hackwerken/SensorGrid-PCB/pdf/sensorGridPcb-3d-2.jpg

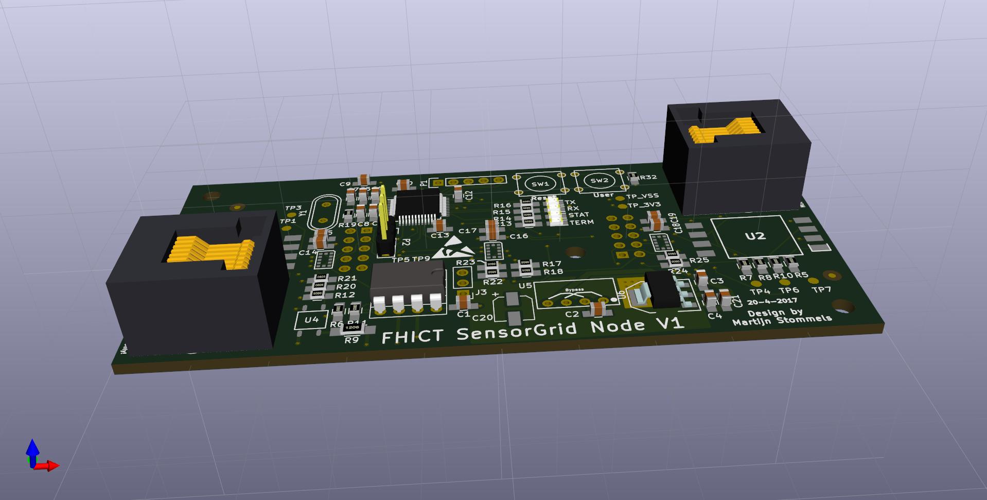
pdf/sensorGridPcb-3d-2.jpg
