hackwerken/SensorGrid-PCB/pdf/sensorGridPcb-3d-4.jpg

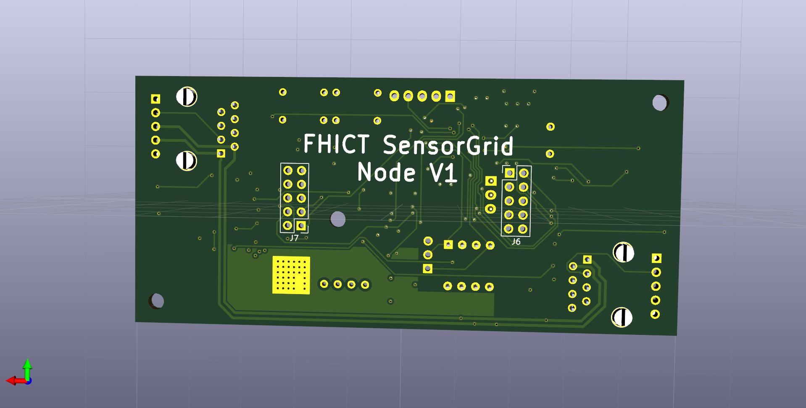
pdf/sensorGridPcb-3d-4.jpg
