hackwerken/SensorGrid-PCB/pdf/sensorGridPcb-3d-1.jpg

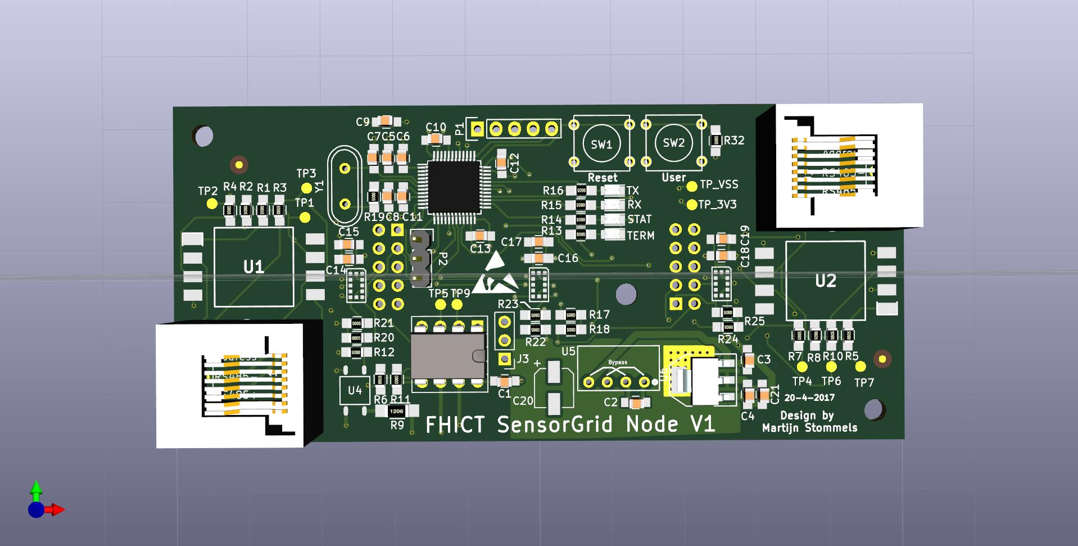
pdf/sensorGridPcb-3d-1.jpg
