hackwerken/SensorGrid-PCB/pdf/sensorGridPcb-3d-3.jpg

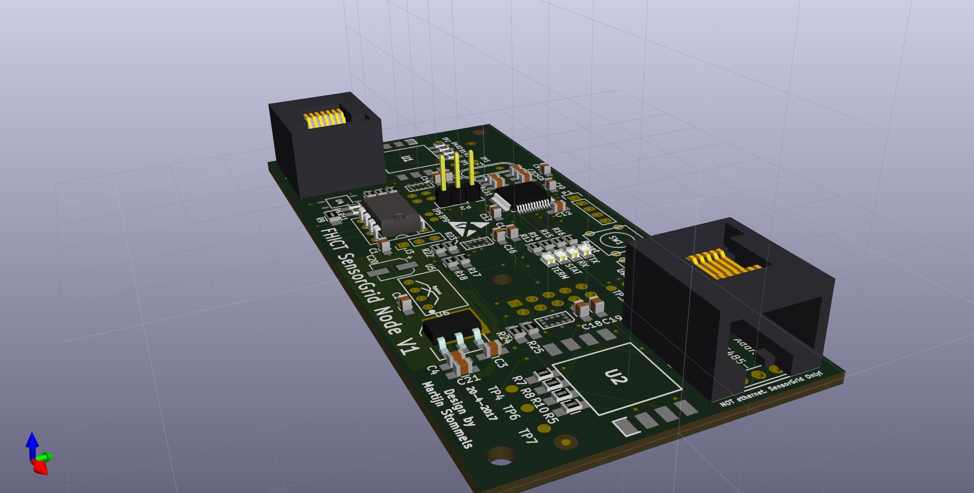
pdf/sensorGridPcb-3d-3.jpg
