hackwerken/SensorGrid-PCB/pdf/sensorGridSchematic.pdf

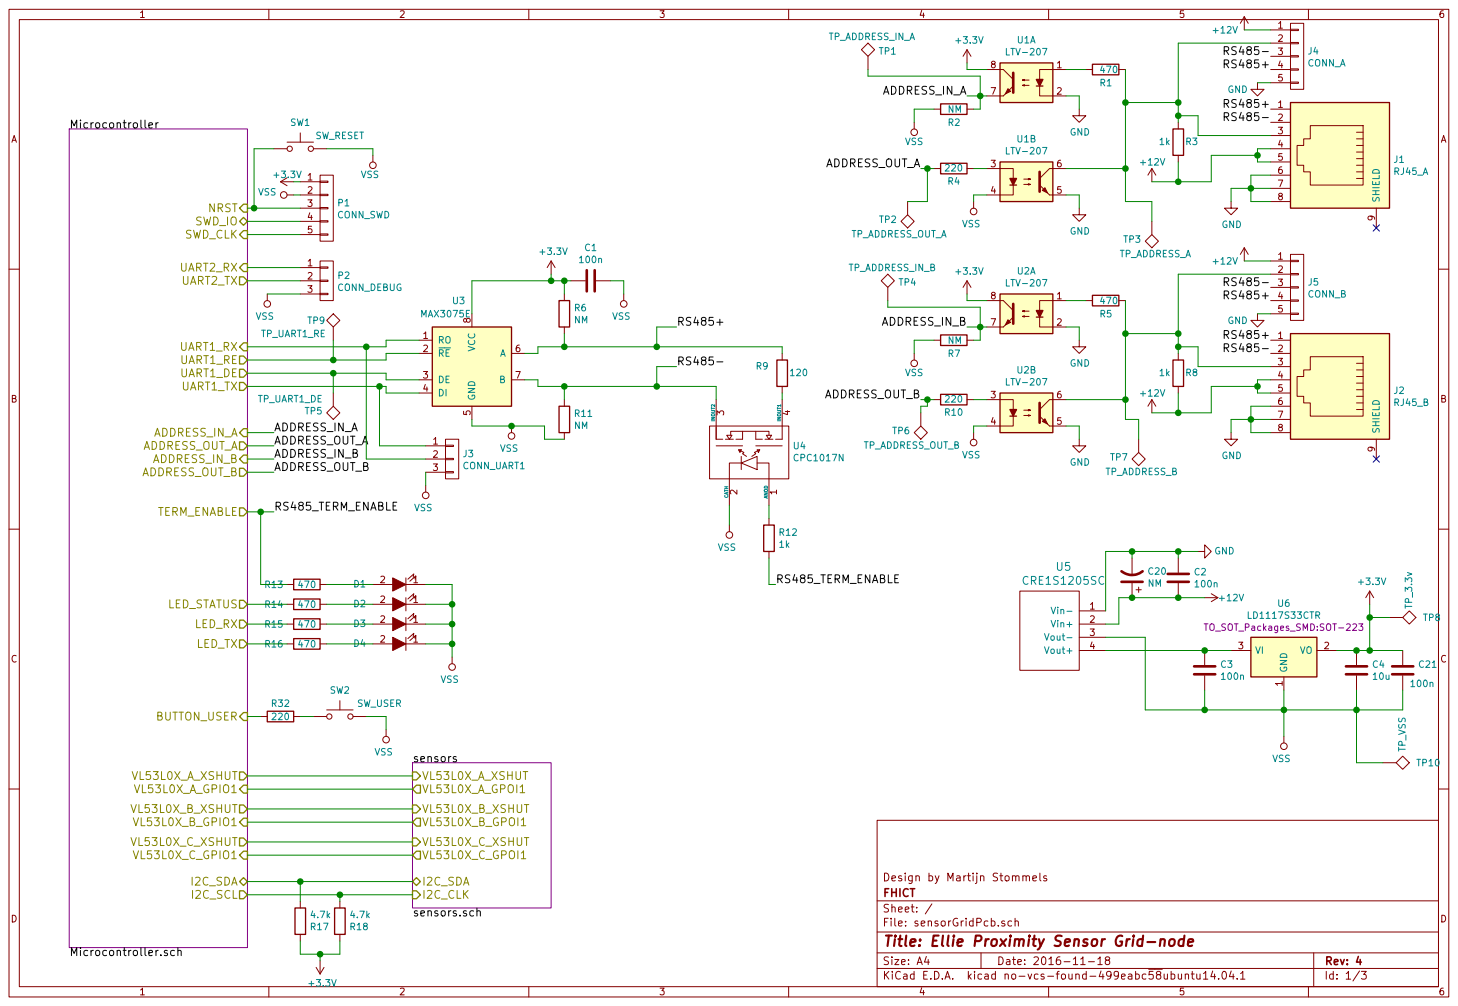
[picture p5: page 1]

File: sensorGridPcb.sch Sheet: / FHICT Design by Martijn Stommels

Id: 1/3 Title: Ellie Proximity Sensor Grid-node

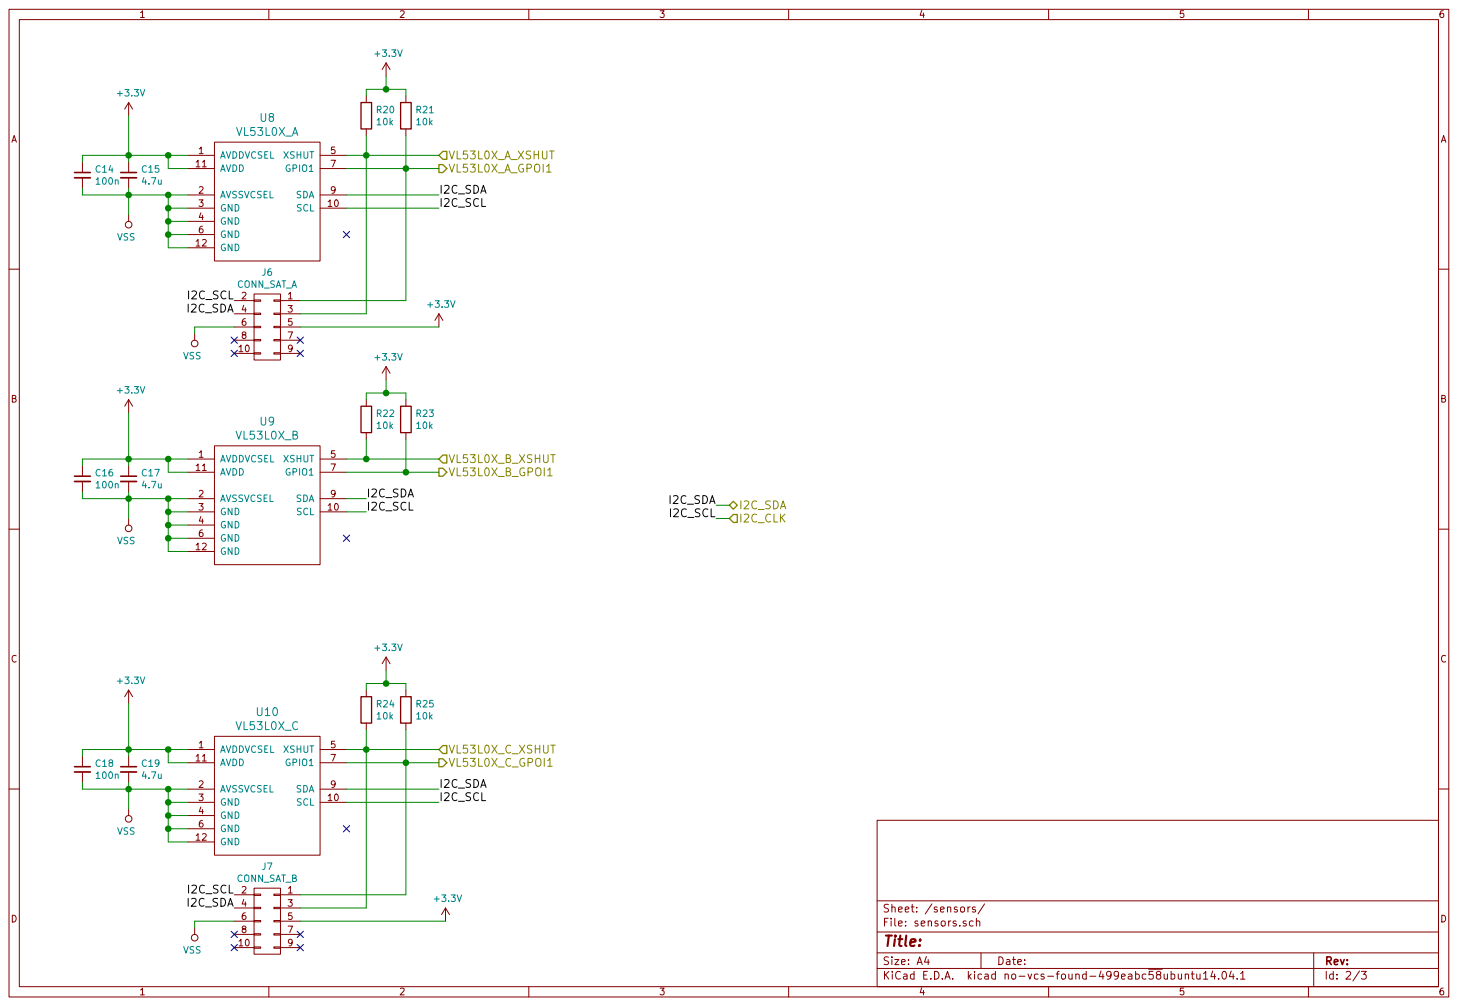
[picture p6: page 2]

Id: 2/3 Title: File: sensors.sch Sheet: /sensors/

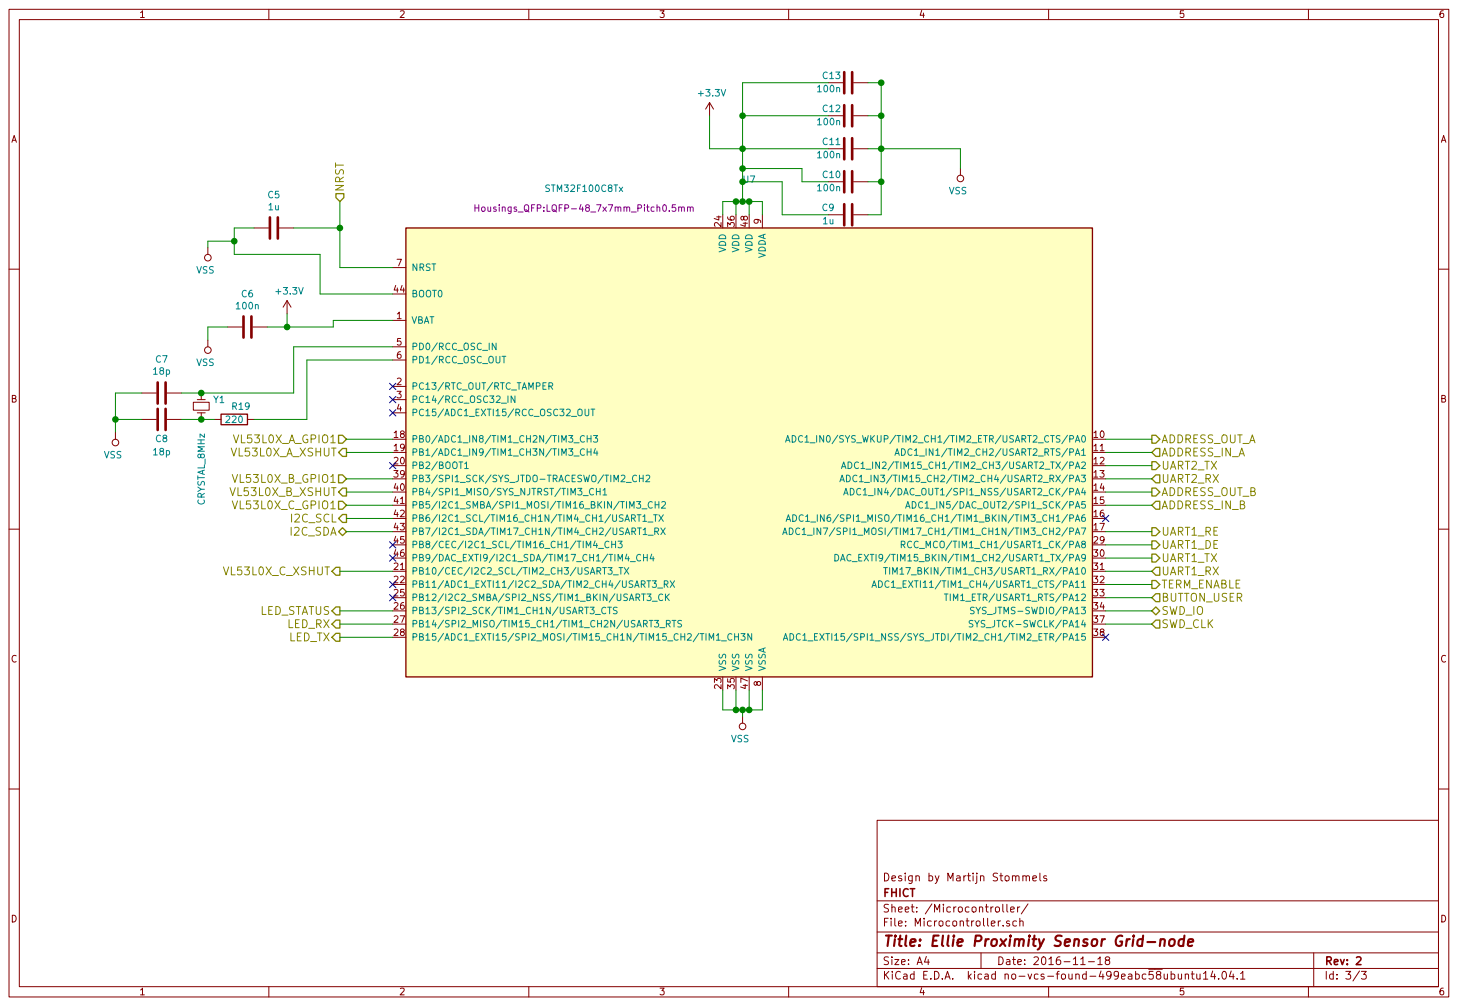
[picture p7: page 3]

9 ADC1_IN0/SYS_WKUP/TIM2_CH1/TIM2_ETR/USART2_CTS/PA0 10 PB2/BOOT1 20 DAC_EXTI9/TIM15_BKIN/TIM1_CH2/USART1_TX/PA9 30 PB4/SPI1_MISO/SYS_NJTRST/TIM3_CH1 40 ADC1_IN1/TIM2_CH2/USART2_RTS/PA1 11 PB10/CEC/I2C2_SCL/TIM2_CH3/USART3_TX 21 TIM17_BKIN/TIM1_CH3/USART1_RX/PA10 31 PB5/I2C1_SMBA/SPI1_MOSI/TIM16_BKIN/TIM3_CH2 41 ADC1_IN2/TIM15_CH1/TIM2_CH3/USART2_TX/PA2 12 PB11/ADC1_EXTI11/I2C2_SDA/TIM2_CH4/USART3_RX 22 ADC1_EXTI11/TIM1_CH4/USART1_CTS/PA11 32 PB6/I2C1_SCL/TIM16_CH1N/TIM4_CH1/USART1_TX 42 ADC1_IN3/TIM15_CH2/TIM2_CH4/USART2_RX/PA3 13 VSS 23 TIM1_ETR/USART1_RTS/PA12 33 PB7/I2C1_SDA/TIM17_CH1N/TIM4_CH2/USART1_RX 43 ADC1_IN4/DAC_OUT1/SPI1_NSS/USART2_CK/PA4 14 VDD 24 SYS_JTMS-SWDIO/PA13 34 BOOT0 44 ADC1_IN5/DAC_OUT2/SPI1_SCK/PA5 15 PB12/I2C2_SMBA/SPI2_NSS/TIM1_BKIN/USART3_CK 25 VSS 35 PB8/CEC/I2C1_SCL/TIM16_CH1/TIM4_CH3 45 ADC1_IN6/SPI1_MISO/TIM16_CH1/TIM1_BKIN/TIM3_CH1/PA6 16 PB13/SPI2_SCK/TIM1_CH1N/USART3_CTS 26 VDD 36 PB9/DAC_EXTI9/I2C1_SDA/TIM17_CH1/TIM4_CH4 46 ADC1_IN7/SPI1_MOSI/TIM17_CH1/TIM1_CH1N/TIM3_CH2/PA7 17 PB14/SPI2_MISO/TIM15_CH1/TIM1_CH2N/USART3_RTS 27 SYS_JTCK-SWCLK/PA14 37 VSS 47 PB0/ADC1_IN8/TIM1_CH2N/TIM3_CH3 18 PB15/ADC1_EXTI15/SPI2_MOSI/TIM15_CH1N/TIM15_CH2/TIM1_CH3N 28 ADC1_EXTI15/SPI1_NSS/SYS_JTDI/TIM2_CH1/TIM2_ETR/PA15 38 VDD 48 PB1/ADC1_IN9/TIM1_CH3N/TIM3_CH4 19 RCC_MCO/TIM1_CH1/USART1_CK/PA8 29 PB3/SPI1_SCK/SYS_JTDO-TRACESWO/TIM2_CH2 39 U7 STM32F100C8Tx Housings_QFP:LQFP-48_7x7mm_Pitch0.5mm

File: Microcontroller.sch Sheet: /Microcontroller/ FHICT Design by Martijn Stommels

Id: 3/3 Title: Ellie Proximity Sensor Grid-node
