hackwerken/SensorGrid-PCB/sensorGridPcb.kicad_pcb

## KiCad design sensorGridPcb.kicad_pcb (2017-04-21)

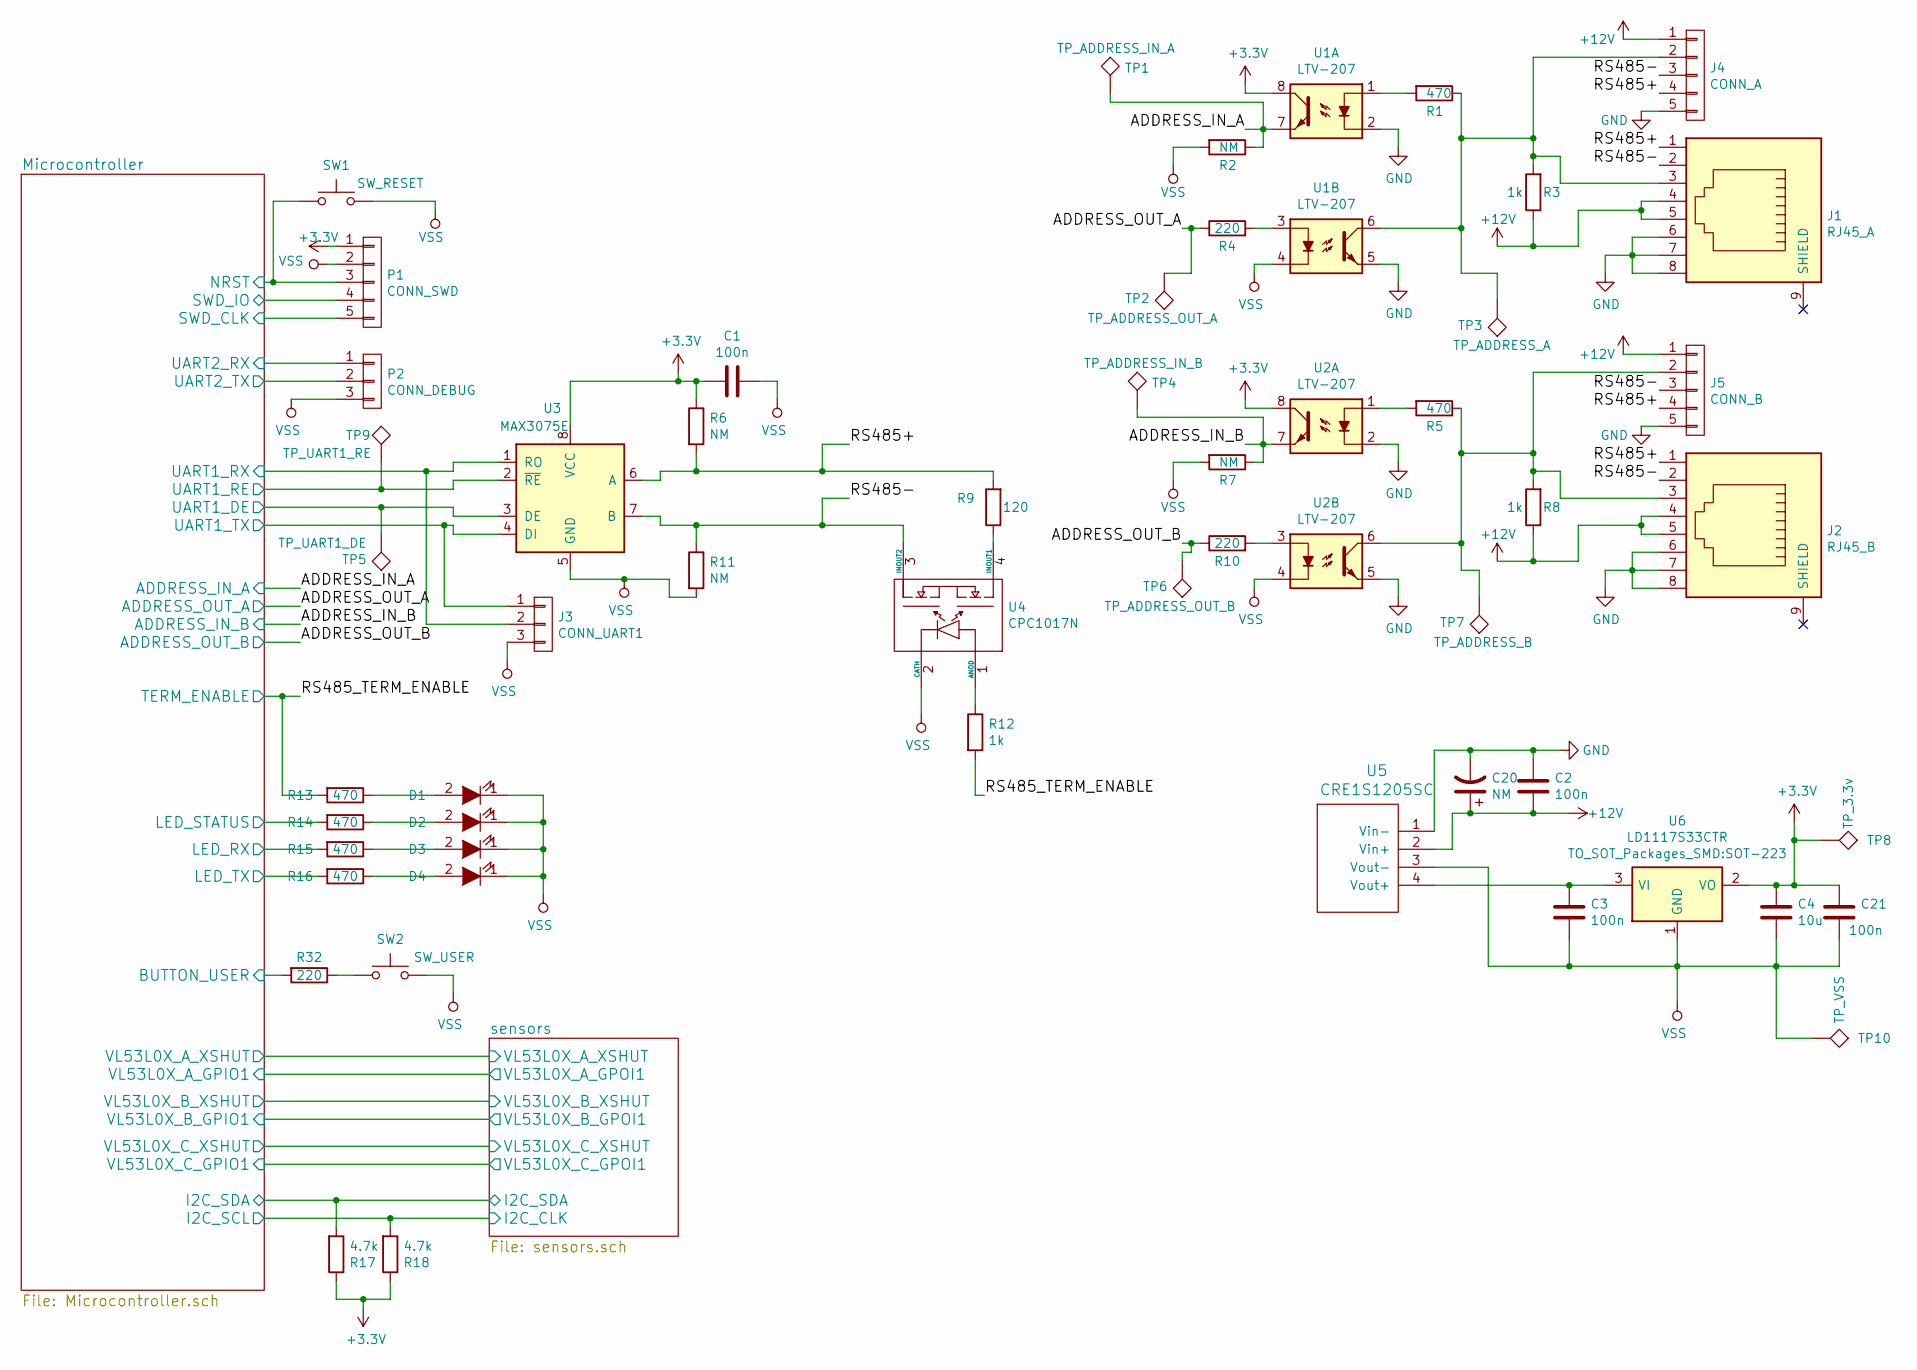
[picture p16: schematic sensorGridPcb.sch, Ellie Proximity Sensor Grid-node]

Parts:
C1, C2, C3: 100n; C_0805_HandSoldering
C4: 10u; C_0805_HandSoldering
C20: NM; CP_Elec_5x5.7
C21: 100n; C_0805
D1: TERM; LED_0805
D2: STAT; LED_0805
D3: RX; LED_0805
D4: TX; LED_0805
J1: RJ45_A; RJ45_8
J2: RJ45_B; RJ45_8
J3: CONN_UART1; Pin_Header_Straight_1x03_Pitch2.54mm
J4: CONN_A; Socket_Strip_Straight_1x05_Pitch2.54mm
J5: CONN_B; Socket_Strip_Straight_1x05_Pitch2.54mm
P1: CONN_SWD; Pin_Header_Straight_1x05
P2: CONN_DEBUG; Pin_Header_Straight_1x03
R1, R5, R13, R14, R15, R16: 470; R_0805_HandSoldering
R2, R6, R7, R11: NM; R_0805_HandSoldering
R3, R8, R12: 1k; R_0805_HandSoldering
R4, R10, R32: 220; R_0805_HandSoldering
R9: 120; R_1206_HandSoldering
R17, R18: 4.7k; R_0805_HandSoldering
SW1: SW_RESET; SW_PUSH_SMALL
SW2: SW_USER; SW_PUSH_SMALL
TP1: TP_ADDRESS_IN_A; Measurement_Point_Round-SMD-Pad_Small
TP2: TP_ADDRESS_OUT_A; Measurement_Point_Round-SMD-Pad_Small
TP3: TP_ADDRESS_A; Measurement_Point_Round-SMD-Pad_Small
TP4: TP_ADDRESS_IN_B; Measurement_Point_Round-SMD-Pad_Small
TP5: TP_UART1_DE; Measurement_Point_Round-SMD-Pad_Small
TP6: TP_ADDRESS_OUT_B; Measurement_Point_Round-SMD-Pad_Small
TP7: TP_ADDRESS_B; Measurement_Point_Round-SMD-Pad_Small
TP8: TP_3.3v; Measurement_Point_Round-SMD-Pad_Small
TP9: TP_UART1_RE; Measurement_Point_Round-SMD-Pad_Small
TP10: TP_VSS; Measurement_Point_Round-SMD-Pad_Small
U1, U2: LTV-207; SOP8
U3: MAX3075E; DIP-8_W7.62mm_Socket
U4: CPC1017N
U5: CRE1S1205SC; CRE1S
U6: LD1117S33CTR; SOT-223

Connections:
+3V3: C1.2, C4.1, C21.1, P1.1, R6.1, R17.1, R18.1, TP8.1, U1.8, U2.8, U3.8 (VCC), U6.2 (VO), U6.4; also elsewhere on the board
+12V: C2.2, C20.1, J1.4, J1.5, J2.4, J2.5, J4.1, J5.1, R3.1, R8.1, U5.2 (Vin+)
/ADDRESS_IN_A: R2.1, TP1.1, U1.7; also elsewhere on the board
/ADDRESS_IN_B: R7.1, TP4.1, U2.7; also elsewhere on the board
/ADDRESS_OUT_A: R4.1, TP2.1; also elsewhere on the board
/ADDRESS_OUT_B: R10.1, TP6.1; also elsewhere on the board
/Microcontroller/BUTTON_USER: R32.2; also elsewhere on the board
/Microcontroller/I2C_SDA: R17.2; also elsewhere on the board
/Microcontroller/LED_RX: R15.2; also elsewhere on the board
/Microcontroller/LED_STATUS: R14.2; also elsewhere on the board
/Microcontroller/LED_TX: R16.2; also elsewhere on the board
/Microcontroller/NRST: P1.3, SW1.1; also elsewhere on the board
/Microcontroller/SWD_CLK: P1.5; also elsewhere on the board
/Microcontroller/SWD_IO: P1.4; also elsewhere on the board
/Microcontroller/UART1_DE: TP5.1, U3.3 (DE); also elsewhere on the board
/Microcontroller/UART1_RE: TP9.1, U3.2 (~RE~); also elsewhere on the board
/Microcontroller/UART1_RX: J3.2, U3.1 (RO); also elsewhere on the board
/Microcontroller/UART1_TX: J3.1, U3.4 (DI); also elsewhere on the board
/Microcontroller/UART2_RX: P2.1; also elsewhere on the board
/Microcontroller/UART2_TX: P2.2; also elsewhere on the board
/RS485+: J1.1, J2.1, J4.4, J5.4, R6.2, R9.2, U3.6 (A)
/RS485-: J1.2, J2.2, J4.3, J5.3, R11.1, U3.7 (B), U4.3 (INOUT2)
/RS485_TERM_ENABLE: R12.2, R13.2; also elsewhere on the board
/sensors/I2C_CLK: R18.2; also elsewhere on the board
GND: C2.1, C20.2, J1.6, J1.7, J1.8, J2.6, J2.7, J2.8, J4.5, J5.5, U1.2, U1.5, U2.2, U2.5, U5.1 (Vin-)
unnamed: C3.1, U5.4 (Vout+), U6.3 (VI)
unnamed: D1.2 (A), R13.1
unnamed: D2.2 (A), R14.1
unnamed: D3.2 (A), R15.1
unnamed: D4.2 (A), R16.1
unnamed: J1.3, J4.2, R1.1, R3.2, TP3.1, U1.6
unnamed: J2.3, J5.2, R5.1, R8.2, TP7.1, U2.6
unnamed: R1.2, U1.1
unnamed: R4.2, U1.3
unnamed: R5.2, U2.1
unnamed: R9.1, U4.4 (INOUT1)
unnamed: R10.2, U2.3
unnamed: R12.1, U4.1 (ANOD)
unnamed: R32.1, SW2.1
VSS: C1.1, C3.2, C4.2, C21.2, D1.1 (K), D2.1 (K), D3.1 (K), D4.1 (K), J3.3, P1.2, P2.3, R2.2, R7.2, R11.2, SW1.2, SW2.2, TP10.1, U1.4, U2.4, U3.5 (GND), U4.2 (CATH), U5.3 (Vout-), U6.1 (GND); also elsewhere on the board

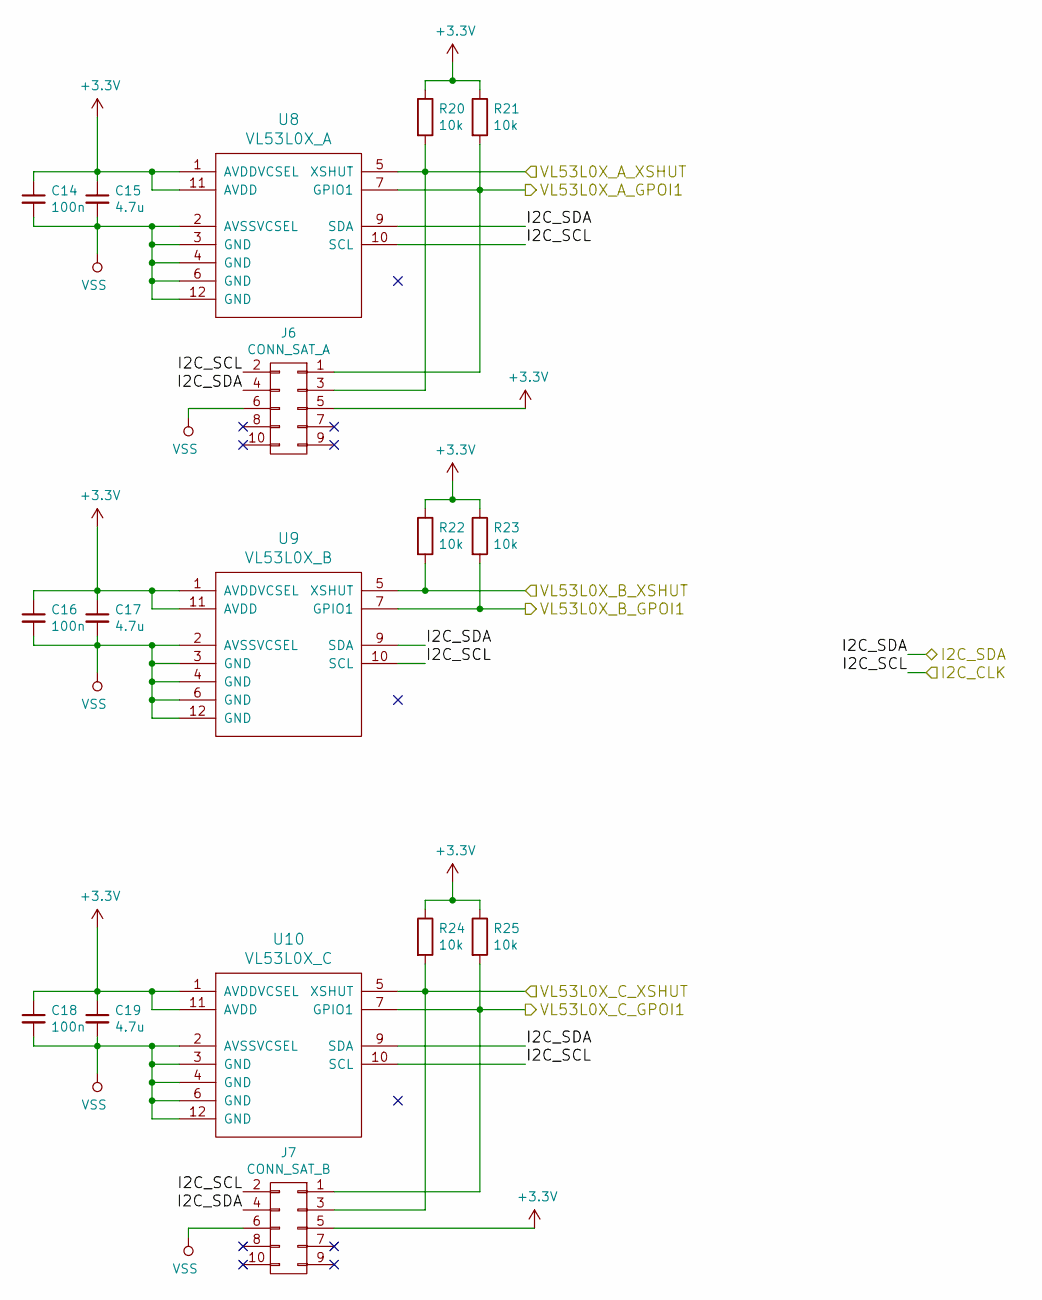
[picture p17: schematic sensors.sch]

Parts:
C14, C16, C18: 100n; C_0805_HandSoldering
C15, C17, C19: 4.7u; C_0805_HandSoldering
J6: CONN_SAT_A; Pin_Header_Straight_2x05_Pitch2.54mm
J7: CONN_SAT_B; Pin_Header_Straight_2x05_Pitch2.54mm
R20, R21, R22, R23, R24, R25: 10k; R_0805_HandSoldering
U8: VL53L0X_A; VL53L0X
U9: VL53L0X_B; VL53L0X
U10: VL53L0X_C; VL53L0X

Connections:
+3V3: C14.1, C15.1, C16.1, C17.1, C18.1, C19.1, J6.5, J7.5, R20.1, R21.1, R22.1, R23.1, R24.1, R25.1, U8.1 (AVDDVCSEL), U8.11 (AVDD), U9.1 (AVDDVCSEL), U9.11 (AVDD), U10.1 (AVDDVCSEL), U10.11 (AVDD); also elsewhere on the board
/Microcontroller/I2C_SDA: J6.4, J7.4, U8.9 (SDA), U9.9 (SDA), U10.9 (SDA); also elsewhere on the board
/Microcontroller/VL53L0X_A_GPIO1: J6.1, R21.2, U8.7 (GPIO1); also elsewhere on the board
/Microcontroller/VL53L0X_A_XSHUT: J6.3, R20.2, U8.5 (XSHUT); also elsewhere on the board
/Microcontroller/VL53L0X_B_GPIO1: R23.2, U9.7 (GPIO1); also elsewhere on the board
/Microcontroller/VL53L0X_B_XSHUT: R22.2, U9.5 (XSHUT); also elsewhere on the board
/Microcontroller/VL53L0X_C_GPIO1: J7.1, R25.2, U10.7 (GPIO1); also elsewhere on the board
/Microcontroller/VL53L0X_C_XSHUT: J7.3, R24.2, U10.5 (XSHUT); also elsewhere on the board
/sensors/I2C_CLK: J6.2, J7.2, U8.10 (SCL), U9.10 (SCL), U10.10 (SCL); also elsewhere on the board
VSS: C14.2, C15.2, C16.2, C17.2, C18.2, C19.2, J6.6, J7.6, U8.2 (AVSSVCSEL), U8.3 (GND), U8.4 (GND), U8.6 (GND), U8.12 (GND), U9.2 (AVSSVCSEL), U9.3 (GND), U9.4 (GND), U9.6 (GND), U9.12 (GND), U10.2 (AVSSVCSEL), U10.3 (GND), U10.4 (GND), U10.6 (GND), U10.12 (GND); also elsewhere on the board

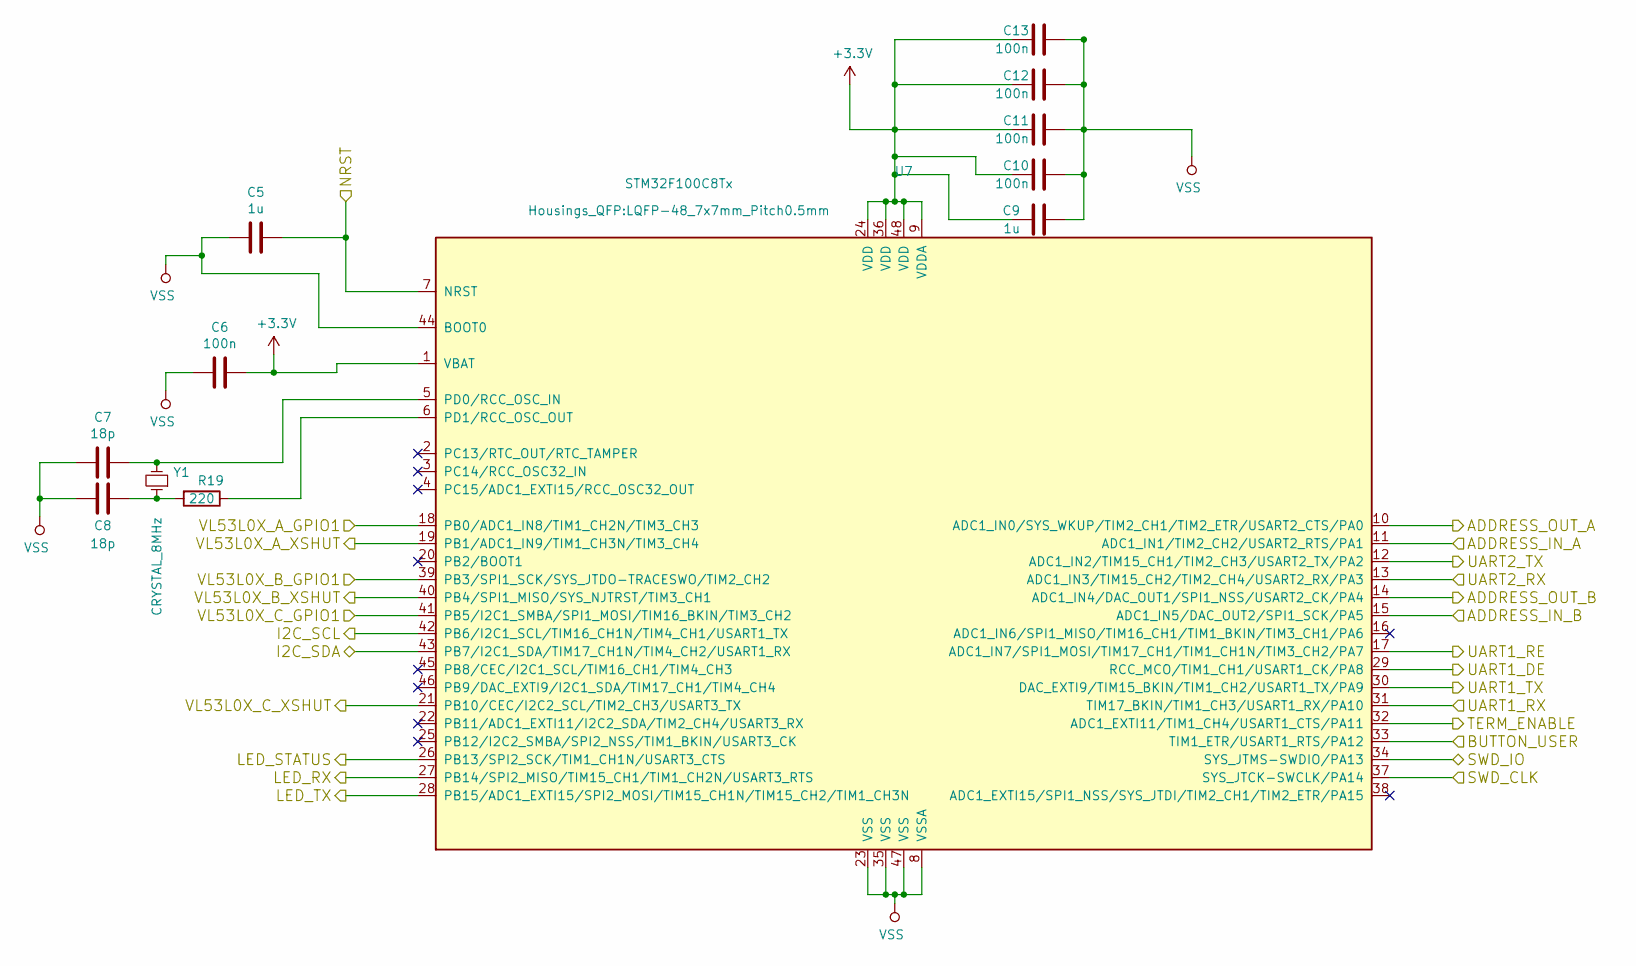
[picture p18: schematic Microcontroller.sch, Ellie Proximity Sensor Grid-node]

Parts:
C5, C9: 1u; C_0805_HandSoldering
C6, C10, C11, C12, C13: 100n; C_0805_HandSoldering
C7, C8: 18p; C_0805_HandSoldering
R19: 220; R_0805_HandSoldering
U7: STM32F100C8Tx; LQFP-48_7x7mm_Pitch0.5mm
Y1: CRYSTAL_8MHz; Crystal_HC49-U_Vertical

Connections:
+3V3: C6.1, C9.1, C10.1, C11.1, C12.1, C13.1, U7.1 (VBAT), U7.9 (VDDA), U7.24 (VDD), U7.36 (VDD), U7.48 (VDD); also elsewhere on the board
/ADDRESS_IN_A: U7.11 (ADC1_IN1/TIM2_CH2/USART2_RTS/PA1); also elsewhere on the board
/ADDRESS_IN_B: U7.15 (ADC1_IN5/DAC_OUT2/SPI1_SCK/PA5); also elsewhere on the board
/ADDRESS_OUT_A: U7.10 (ADC1_IN0/SYS_WKUP/TIM2_CH1/TIM2_ETR/USA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); also elsewhere on the board
/ADDRESS_OUT_B: U7.14 (ADC1_IN4/DAC_OUT1/SPI1_NSS/USART2_CK/PA4); also elsewhere on the board
/Microcontroller/BUTTON_USER: U7.33 (TIM1_ETR/USART1_RTS/PA12); also elsewhere on the board
/Microcontroller/I2C_SDA: U7.43 (PB7/I2C1_SDA/TIM17_CH1N/TIM4_CH2/USART1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); also elsewhere on the board
/Microcontroller/LED_RX: U7.27 (PB14/SPI2_MISO/TIM15_CH1/TIM1_CH2N/USAR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); also elsewhere on the board
/Microcontroller/LED_STATUS: U7.26 (PB13/SPI2_SCK/TIM1_CH1N/USART3_CTS); also elsewhere on the board
/Microcontroller/LED_TX: U7.28 (PB15/ADC1_EXTI15/SPI2_MOSI/TIM15_CH1N/T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); also elsewhere on the board
/Microcontroller/NRST: C5.1, U7.7 (NRST); also elsewhere on the board
/Microcontroller/SWD_CLK: U7.37 (SYS_JTCK-SWCLK/PA14); also elsewhere on the board
/Microcontroller/SWD_IO: U7.34 (SYS_JTMS-SWDIO/PA13); also elsewhere on the board
/Microcontroller/UART1_DE: U7.29 (RCC_MCO/TIM1_CH1/USART1_CK/PA8); also elsewhere on the board
/Microcontroller/UART1_RE: U7.17 (ADC1_IN7/SPI1_MOSI/TIM17_CH1/TIM1_CH1N/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); also elsewhere on the board
/Microcontroller/UART1_RX: U7.31 (TIM17_BKIN/TIM1_CH3/USART1_RX/PA10); also elsewhere on the board
/Microcontroller/UART1_TX: U7.30 (DAC_EXTI9/TIM15_BKIN/TIM1_CH2/USART1_TX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); also elsewhere on the board
/Microcontroller/UART2_RX: U7.13 (ADC1_IN3/TIM15_CH2/TIM2_CH4/USART2_RX/P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); also elsewhere on the board
/Microcontroller/UART2_TX: U7.12 (ADC1_IN2/TIM15_CH1/TIM2_CH3/USART2_TX/P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); also elsewhere on the board
/Microcontroller/VL53L0X_A_GPIO1: U7.18 (PB0/ADC1_IN8/TIM1_CH2N/TIM3_CH3); also elsewhere on the board
/Microcontroller/VL53L0X_A_XSHUT: U7.19 (PB1/ADC1_IN9/TIM1_CH3N/TIM3_CH4); also elsewhere on the board
/Microcontroller/VL53L0X_B_GPIO1: U7.39 (PB3/SPI1_SCK/SYS_JTDO-TRACESWO/TIM2_CH2); also elsewhere on the board
/Microcontroller/VL53L0X_B_XSHUT: U7.40 (PB4/SPI1_MISO/SYS_NJTRST/TIM3_CH1); also elsewhere on the board
/Microcontroller/VL53L0X_C_GPIO1: U7.41 (PB5/I2C1_SMBA/SPI1_MOSI/TIM16_BKIN/TIM3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); also elsewhere on the board
/Microcontroller/VL53L0X_C_XSHUT: U7.21 (PB10/CEC/I2C2_SCL/TIM2_CH3/USART3_TX); also elsewhere on the board
/RS485_TERM_ENABLE: U7.32 (ADC1_EXTI11/TIM1_CH4/USART1_CTS/PA11); also elsewhere on the board
/sensors/I2C_CLK: U7.42 (PB6/I2C1_SCL/TIM16_CH1N/TIM4_CH1/USART1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); also elsewhere on the board
unnamed: C7.2, U7.5 (PD0/RCC_OSC_IN), Y1.2
unnamed: C8.2, R19.2, Y1.1
unnamed: R19.1, U7.6 (PD1/RCC_OSC_OUT)
VSS: C5.2, C6.2, C7.1, C8.1, C9.2, C10.2, C11.2, C12.2, C13.2, U7.8 (VSSA), U7.23 (VSS), U7.35 (VSS), U7.44 (BOOT0), U7.47 (VSS); also elsewhere on the board

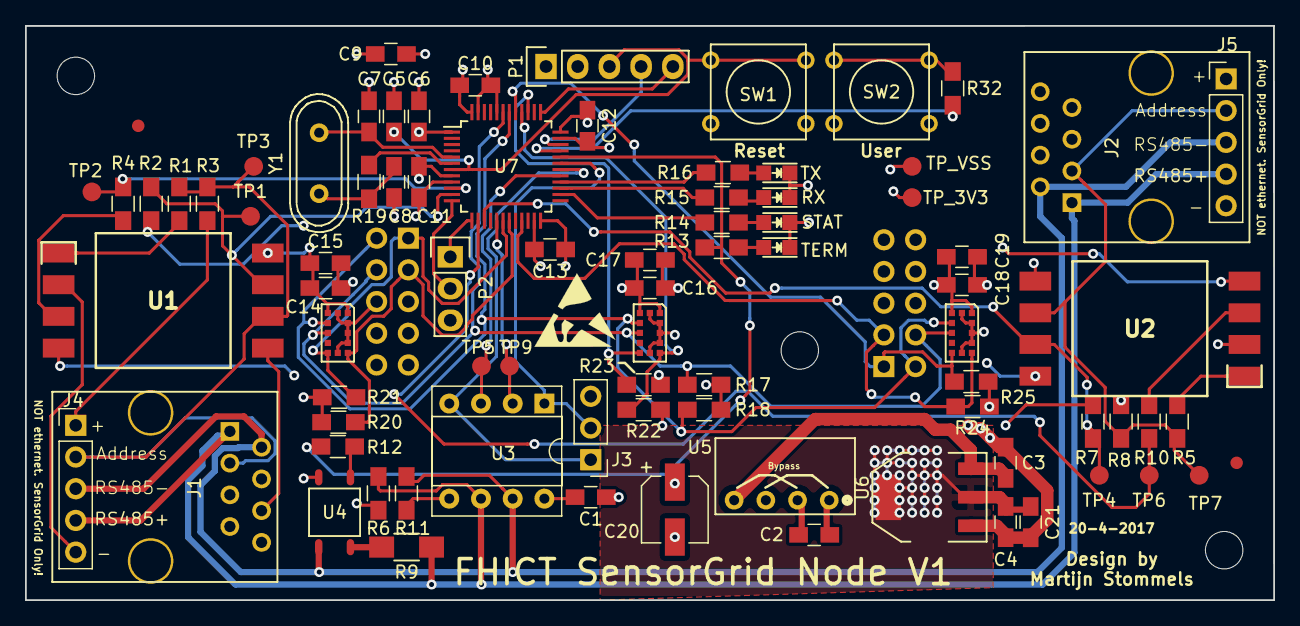
[picture p19: board sensorGridPcb.kicad_pcb from above]

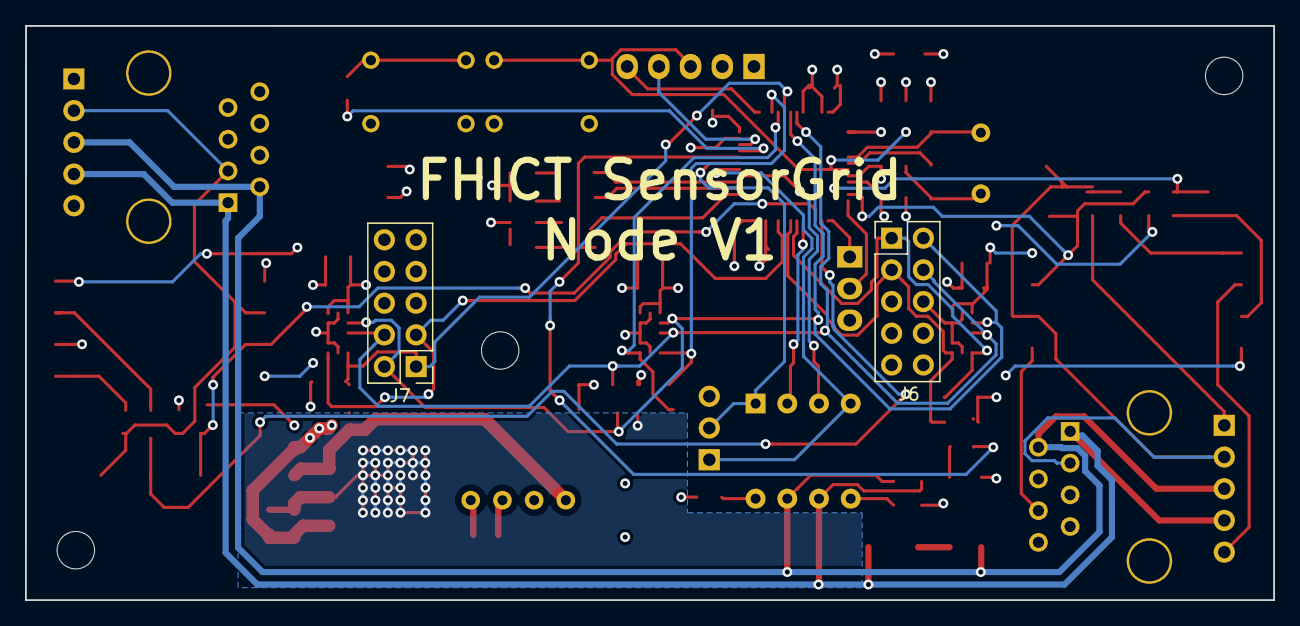
[picture p20: board sensorGridPcb.kicad_pcb from below]

Board: 4 copper layers, 100.0 x 46.0 mm, 83 parts (2 on the bottom side), 49 nets.

Other parts of the board:
TP_3V3: TP_3.3v; Measurement_Point_Round-SMD-Pad_Small
TP_VSS: TP_VSS; Measurement_Point_Round-SMD-Pad_Small

Their connections:
+3V3: TP_3V3.1; also elsewhere on the board
VSS: TP_VSS.1; also elsewhere on the board
