hackwerken/SensorGrid-PCB/(commit log)

2016-12-01 Rev 1.
    [Microcontroller.sch, sensorGridPcb.kicad_pcb, sensorGridPcb.sch, sensors.sch]
2017-04-21 Finished rev4
    [Microcontroller.sch, sensorGridPcb.kicad_pcb, sensorGridPcb.sch, sensors.sch]
2017-05-19 Added pdf exports of the schematic and pcb.
